40000ft/picoPOKER/kicad/picoPOKER.pdf

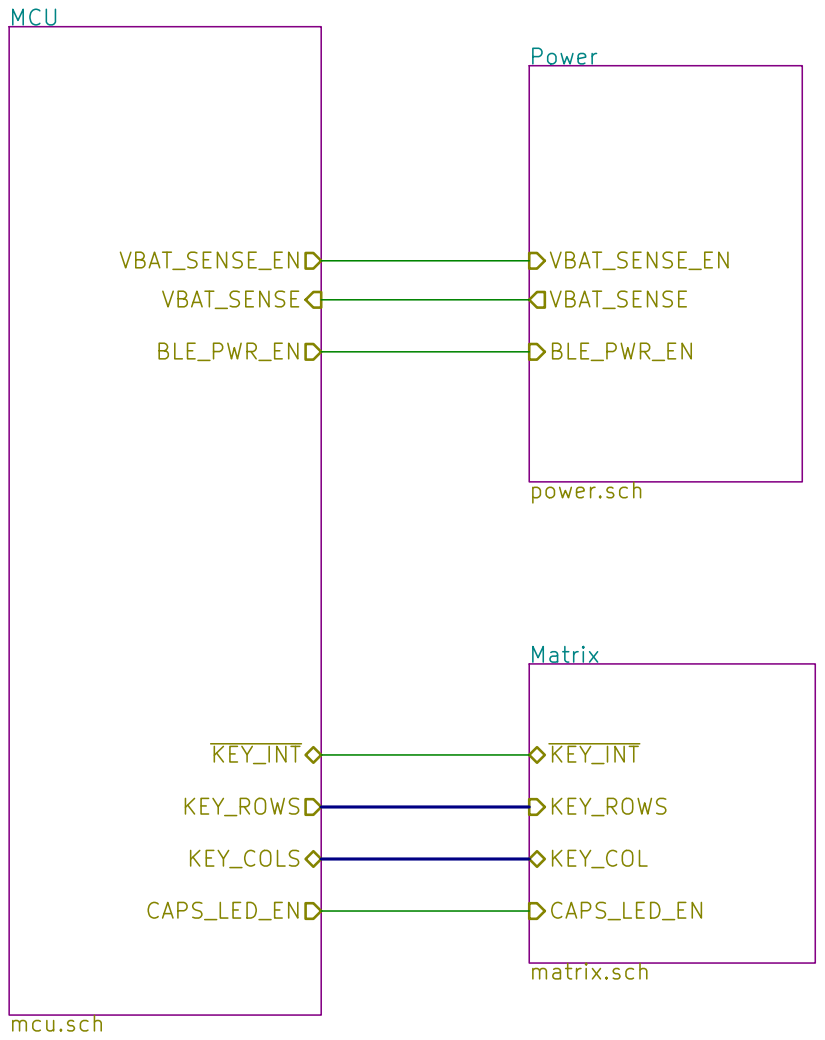
[picture p1: page 1]

File: picoPOKER.sch Sheet: / otto.40000ft@gmail.com

Id: 1/4 Title: picoPOKER Keyboard

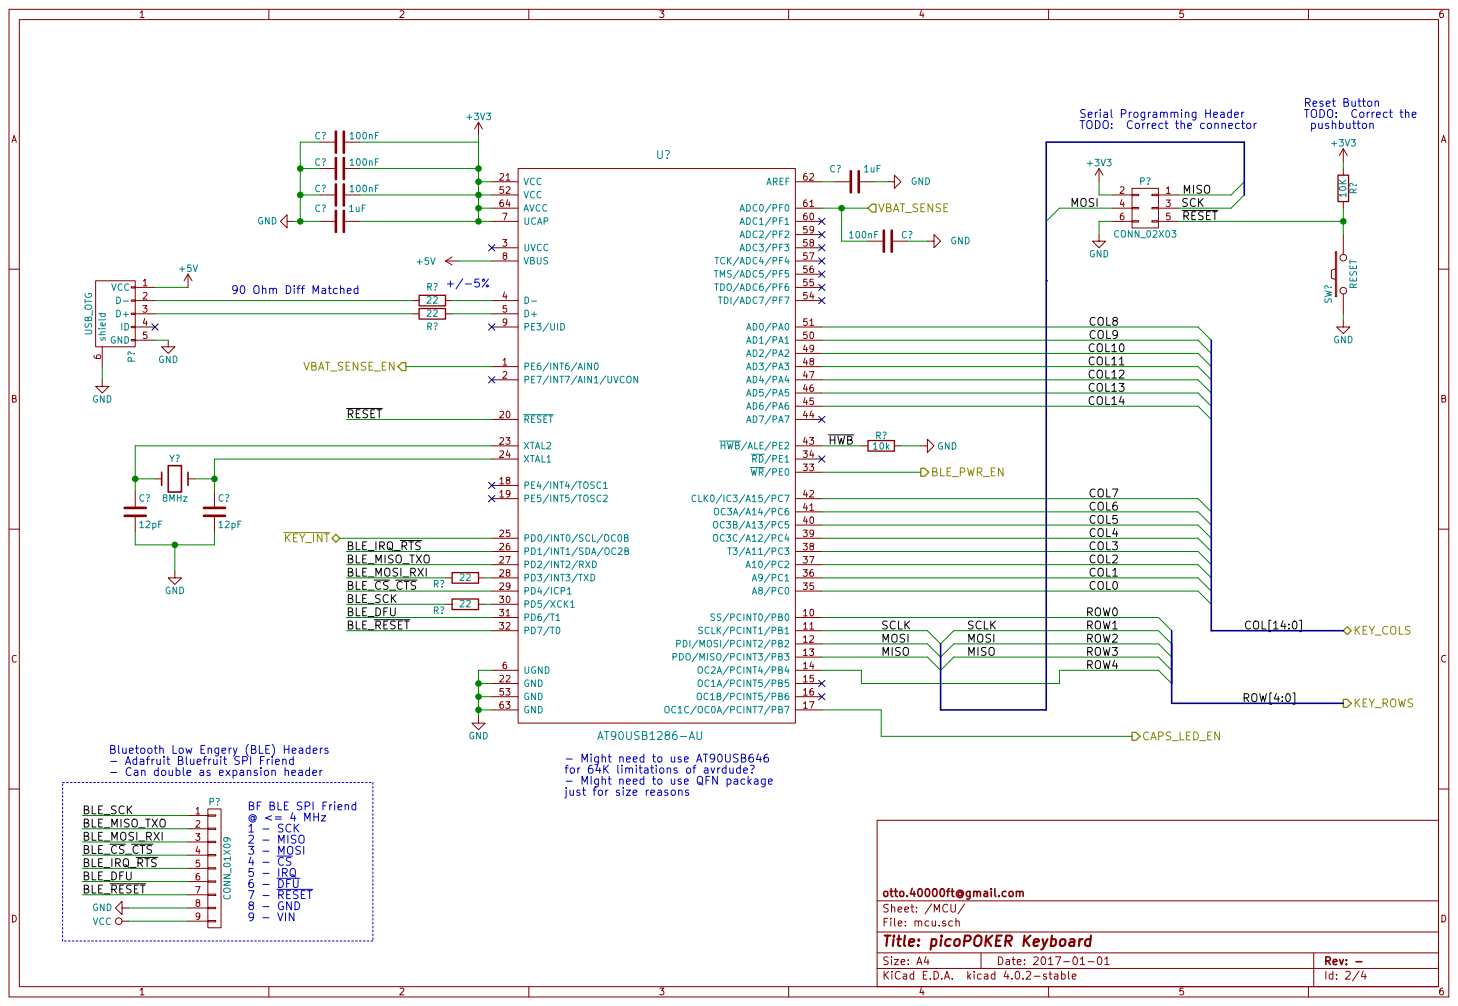
[picture p2: page 2]

+3V3 GND Serial Programming Header

COL10
COL11
COL12
COL13
COL14

COL6
COL5
COL4
COL3

COL1
COL0

Bluetooth Low Engery (BLE) Headers
- Adafruit Bluefruit SPI Friend
9 P? CONN_01X09

- Might need to use AT90USB646
for 64K limitations of avrdude?
- MIght need to use QFN package
just for size reasons

File: mcu.sch Sheet: /MCU/ otto.40000ft@gmail.com

Id: 2/4 Title: picoPOKER Keyboard

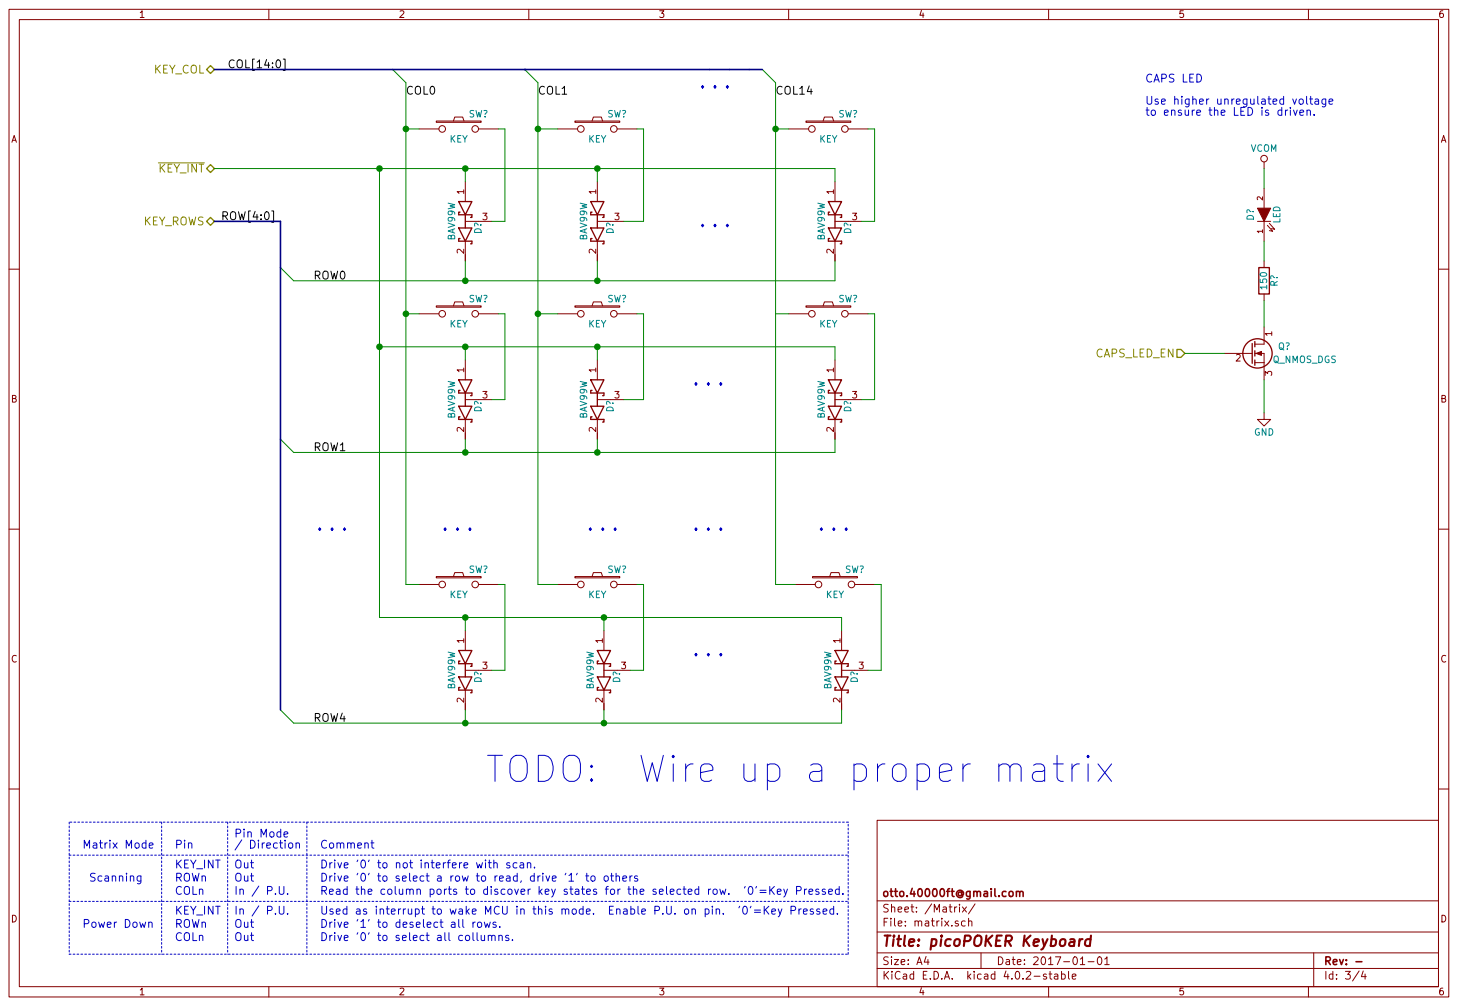
[picture p3: page 3]

CAPS LED
Use higher unregulated voltage

to ensure the LED is driven. TODO: Wire up a proper matrix

/ Direction | Comment

ROWn | Out | Read the column ports to discover key states for the selected row. '0'=Key Pressed. Drive '0' to not interfere with scan. KEY_INT

Drive '0' to select a row to read, drive '1' to others

File: matrix.sch Sheet: /Matrix/ otto.40000ft@gmail.com

Id: 3/4 Title: picoPOKER Keyboard

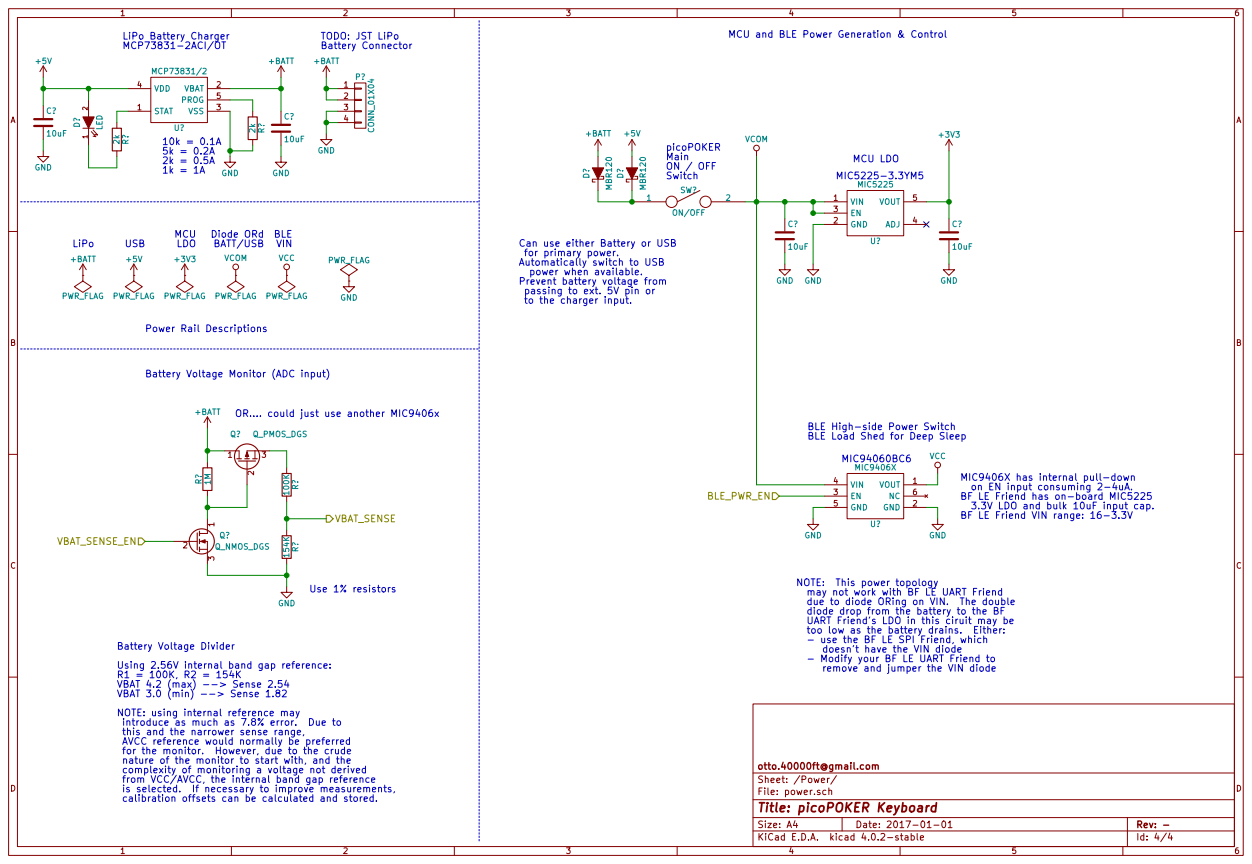
[picture p4: page 4]

MCU and BLE Power Generation & Control Use 1% resistors Battery Voltage Monitor (ADC input)
LiPo Battery Charger
MCP73831-2ACI/OT

picoPOKER Main ON / OFF

Can use either Battery or USB
for primary power.
Automatically switch to USB
power when available.
Prevent battery voltage from
passing to ext. 5V pin or

calibration offsets can be calculated and stored. OR.... could just use another MIC9406x

BLE Load Shed for Deep Sleep

MIC9406X has internal pull-down
on EN input consuming 2-4uA.
BF LE Friend has on-board MIC5225
3.3V LDO and bulk 10uF input cap.
BF LE Friend VIN range: 16-3.3V

may not work with BF LE UART Friend
due to diode ORing on VIN. The double
diode drop from the battery to the BF
UART Friend's LDO in this ciruit may be
too low as the battery drains. Either:
- use the BF LE SPI Friend, which
doesn't have the VIN diode
- Modify your BF LE UART Friend to
remove and jumper the VIN diode

Battery Voltage Divider
Using 2.56V internal band gap reference:
VBAT 4.2 (max) --> Sense 2.54
VBAT 3.0 (min) --> Sense 1.82
NOTE: using internal reference may
introduce as much as 7.8% error. Due to
this and the narrower sense range,
AVCC reference would normally be preferred
for the monitor. However, due to the crude
nature of the monitor to start with, and the
complexity of monitoring a voltage not derived
from VCC/AVCC, the internal band gap reference
is selected. If necessary to improve measurements,

File: power.sch Sheet: /Power/ otto.40000ft@gmail.com

Id: 4/4 Title: picoPOKER Keyboard
