40000ft/picoPOKER/(threads)

Thread 3 (2016-12-30):

External BOD circuit and HWB pull-down may execute bootloader at initial power on

40000ft, 2016-12-30:
To save power, the internal BOD Fuses are recommended to be disabled.  In order to provide some protection for strange behaviors as battery drains, a low power external BOD reset circuit is provided.  However, because HWB pin is used to execute boot loader for external resets, the external BOD circuit may cause bootloader to run at every initial power-up, which is not desired.  Bootloader should run only when reset button is pressed.

Need to look into whether this is actually a problem (perhaps cold power up does not create this issue).

Options:
1. consider running without BOD circuit at all.
2. keep BOD circuit as a SW function
3. custom bootloader logic to deal with this at initial power-on-reset

40000ft, 2016-12-31:
Perhaps keeping the external low-power BOD circuit would work if BOD were used as a SW function.

Instead of running the output to the AVR reset line, run it to a GPIO/Interrupt.  SW can monitor this input at regular intervals or set it up as an interrupt.  When detected, run something like the following:

```
// DIE - power down, never wake up
//  This call will never wake because interrupts were disabled, but weren't
//   re-enabled before calling sleep_cpu().  This will put the AVR in a low-power
//   quiescent state that only a power cycle can bring it back from.
prepare_for_death();
set_PRR();
set_sleep_mode(SLEEP_MODE_PWR_DOWN);
cli();
sleep_enable();
sleep_cpu();
```

This has the disadvantage of, when the battery gets sufficiently low to trigger this, simply plugging the USB power in will be insufficient to wake the keyboard if the battery hasn't drained low enough to trigger the PORRST.

40000ft, 2016-12-31:
Also consider a case where letting bootloader run at every reset could be made to work.  Not sure this is feasible, but something to think about.  Is probably an over-complicated way to solve a rare problem.

Attempt to transfer control to user application if:

Only run bootloader functions if:

40000ft, 2016-12-31:
# Running w/o BOD
It is also possible that BOD is not required at all.

AVR will run down to 2.7V @ 8MHz, well below the LDO setting of 3.3V, or what the battery can produce (3.4V is min operational).

The concern would only be damage to the battery / LDOs if the circuit continues to operate / draw power at those low levels.  There doesn't appear to be any risk to the AVR misbehaving.

40000ft, 2017-01-01:
Decided to run w/o BOD.

Battery protection will cut-out around 3.0V, which is 2.7 to the LDO input.  LDO input should try to track battery voltage down after the LDO input drops below ~3.6.

This appears to be the least complicated solution.  Time will tell whether this solution generates any problems.

Closed 2017-01-01.

Thread 6 (2016-12-31):

Determine programming sequence for raw AVR

40000ft, 2016-12-31:
Raw AVR comes with Atmel DFU bootloader and standard fuses.  Need a plan for:
1. How to get fuses updated
2. Need to replace Atmel DFU bootloader with custom?
3.  How to install Application?

Option 1:  Try to program fuses and new bootloader in-circuit (on picoPOKER)
Option 2:  Program fuses and new bootloader as piece part (may need to be a socket setup)

Either way, use avrdude to program fuses and and new bootloader.  Note avrdude / programmer limitations with devices having > 64K flash.
If sticking with DFU, use dfu-programmer or can possibly use avrdude if > v6.1.

New bootloader should be able to program user applications over USB.  Good hobby options:
1.  LUFA DFU - avrdude / programmers may not support device with > 64K flash, limited to cmd line updates.  Consider using AT90USB646 instead of AT90USB1286.
2. LUFA HID - small, no drivers needed, but limited to command line updates
3. LUFA Mass Storage - large, may need drivers, but drag'n'drop program

40000ft, 2017-01-01:
1.  Added a serial programming header to the AVR.  Can use this to program fuses and update bootloaders in-circuit.
3.  DFU isn't supported in avrdude until rev 6.1.  I'll need an avrdude update or download / install dfu-programmer.  Either way, updating apps through USB shouldn't be a problem.
