40000ft/picoPOKER/(commit log)

2016-12-30 Add vi swap files and github's stock KiCAD ignores to .gitignore
2016-12-30 Add Bluefruit BLE Friend SPI vs UART trade study
2016-12-30 Initial battery life esimtates
2016-12-30 Initial schematic capture. Key matrix still needs definition for each key.
    [matrix.sch, mcu.sch, picoPOKER.sch, power.sch]
2017-01-01 Closes #3.
    This update includes the following fixes and changes:
    - removal of the BOD circuit. It is recommended to simply run without a BOD circuit. BOD fuses should be disabled in the AVR. The LiPo battery should have an integrated UVLO protection circuit which will disconnect the battery when it reaches 3.0V. Due to diode drops, the LDO input will be ~2.7V and the LDO should be producing an output close to this. This should be a sufficient protection for brown-out since the AVR can run @ 8MHz down to 2.7V. Other solutions were getting too complicated.
    - no longer supports running off of either unregulated battery, only regulated 3.3V. Again, supporting all the alternatives was gett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
    [matrix.sch, mcu.sch, picoPOKER.sch, power.sch]
2017-01-01 Add duty-cycle sub-totals to each compmonent power estimate
2017-01-01 Remove support for Bluefruit LE UART Friend
    Header is removed for UART Friend. Supporting only SPI Friend going forward.
    Add a BLE_RESET signal to the SPI Friend BLE header. Don't plan on using it, but will be nice if the header is used as generic expansion.
    Move the BLE_PWR_EN signal to make room for the BLE_RESET signal.
    [matrix.sch, mcu.sch, power.sch]
